henryalejandrorieraloza-sudo/WRO-2026-Future-Engineers-Journal/video/video.md

# Performance videos

Rule 7 of the WRO 2026 Future Engineers General Rules asks for **one YouTube video for each challenge** (public or accessible by link), where the part showing the vehicle **driving autonomously lasts at least 30 seconds**.

| Challenge | Video | Status |
|---|---|---|
| Open Challenge (3 laps, random inner walls, stop in the starting section) | — | In progress — to record with the final Open Challenge program |
| Obstacle Challenge (3 laps obeying red / green pillars, then parallel parking) | — | In progress — to record with the final Obstacle Challenge program |
| Earlier autonomous driving demonstration | https://www.youtube.com/watch?v=J5yrJuZZ5P8 | Done |

**Recording checklist:** one continuous take; show the car switched off in the starting zone, the power switch, the start button and then the whole run without touching the car; at least 30 s of autonomous driving; say the driving direction and the date in the video description.

Team channel: https://www.youtube.com/@SJVL67
