henryalejandrorieraloza-sudo/WRO-2026-Future-Engineers-Journal/t-photos/README.md

# Team photos

| Official photo | Fun photo |
|---|---|
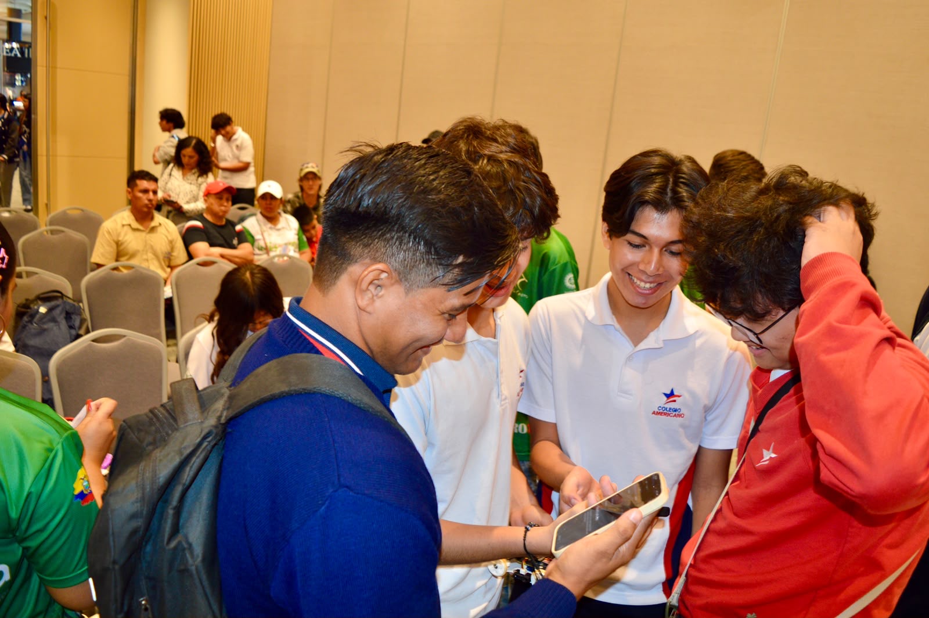
[picture p91: t-photos/team_funny.jpg]
|  |  |
| Team X67 with our coach at the WRO 2026 Ecuador national final | Reviewing a test run on a phone during the national final |

More pictures of the competition day are in [`../other/team-journey`](../other/team-journey).
