henryalejandrorieraloza-sudo/WRO-2026-Future-Engineers-Journal/other/team-journey/opening_ceremony.jpg

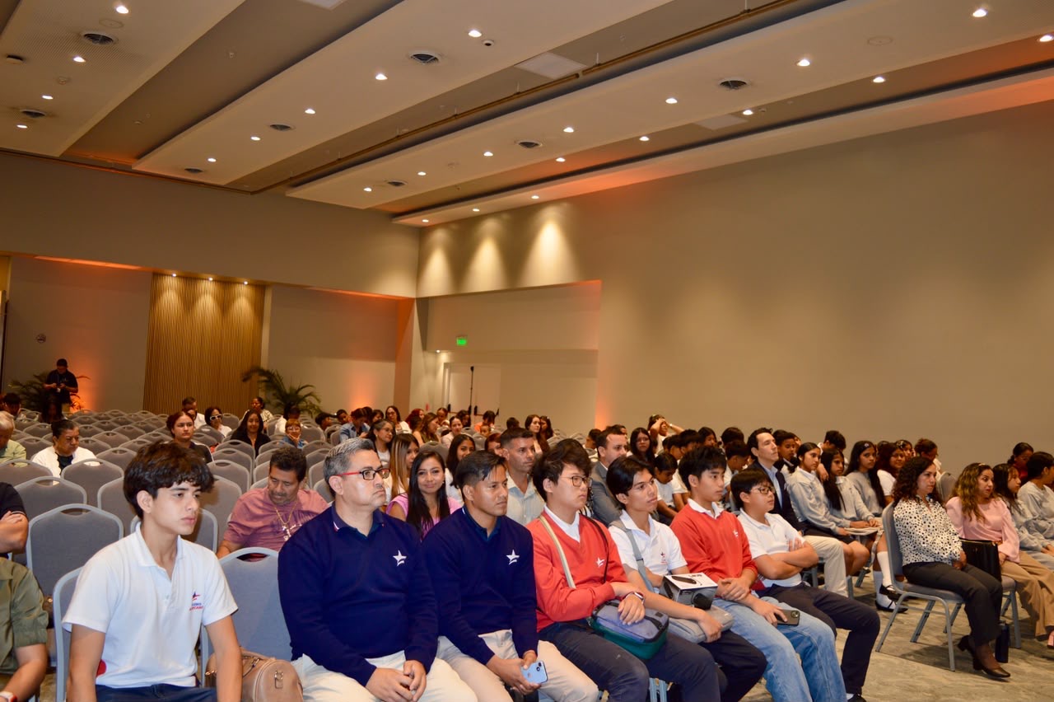
other/team-journey/opening_ceremony.jpg
