henryalejandrorieraloza-sudo/WRO-2026-Future-Engineers-Journal/other/team-journey/press_interview.jpg

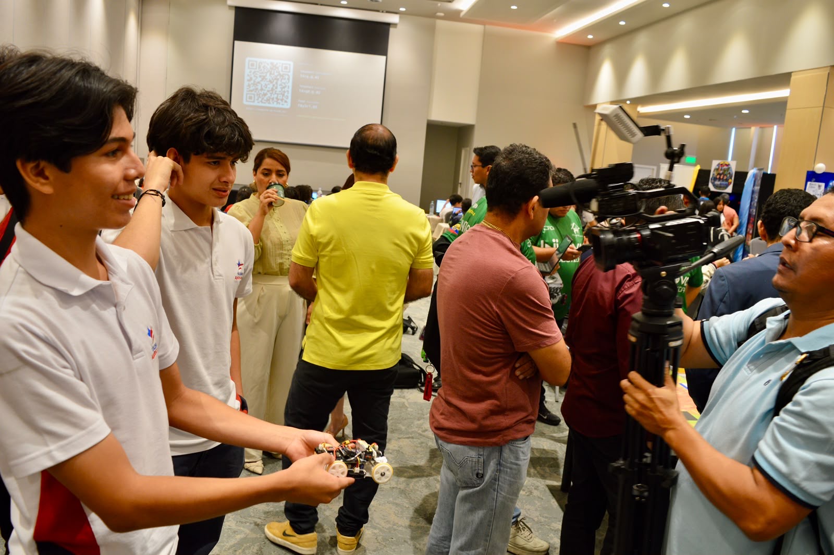
other/team-journey/press_interview.jpg
