henryalejandrorieraloza-sudo/WRO-2026-Future-Engineers-Journal/other/team-journey/robot_presentation_1.jpg

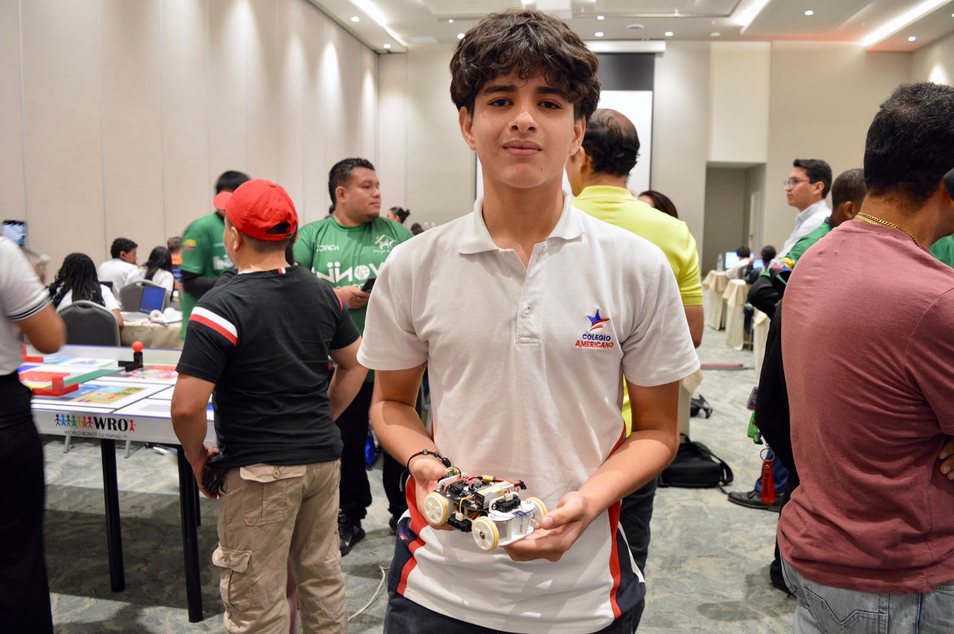
other/team-journey/robot_presentation_1.jpg
