henryalejandrorieraloza-sudo/WRO-2026-Future-Engineers-Journal/models/stl/steering_gear.stl

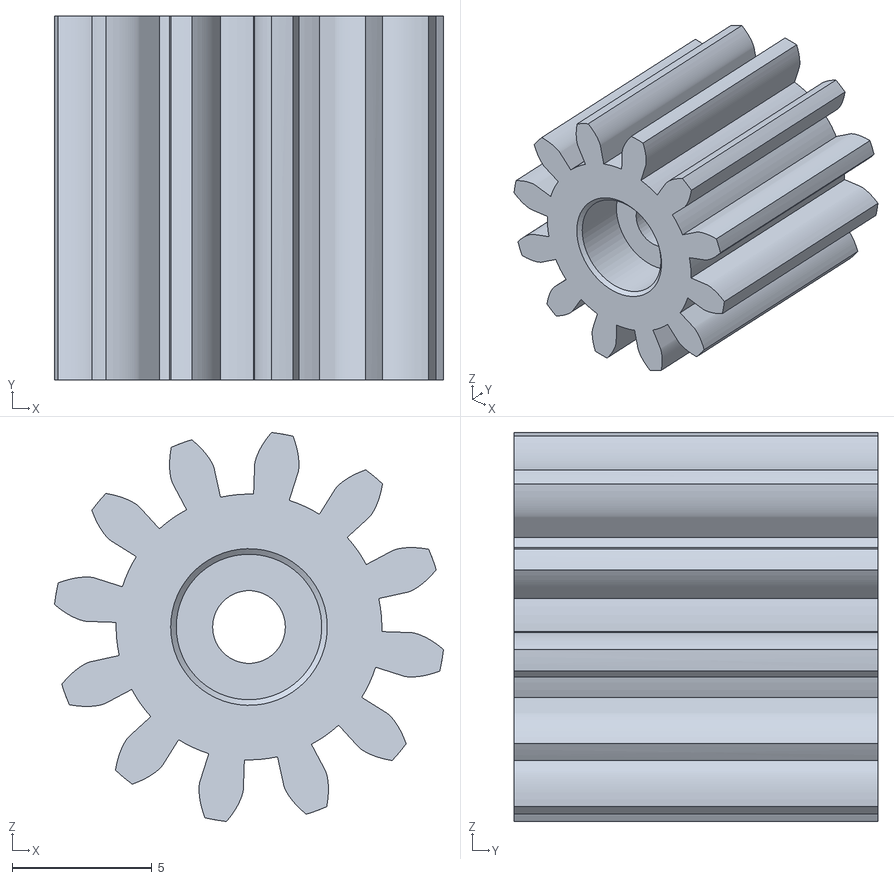
[picture p96: CAD file, 2026-10-19]
models/stl/steering_gear.stl
13.9 x 13.0 x 13.9
