henryalejandrorieraloza-sudo/WRO-2026-Future-Engineers-Journal/models/stl/pcb_big_support_left.stl

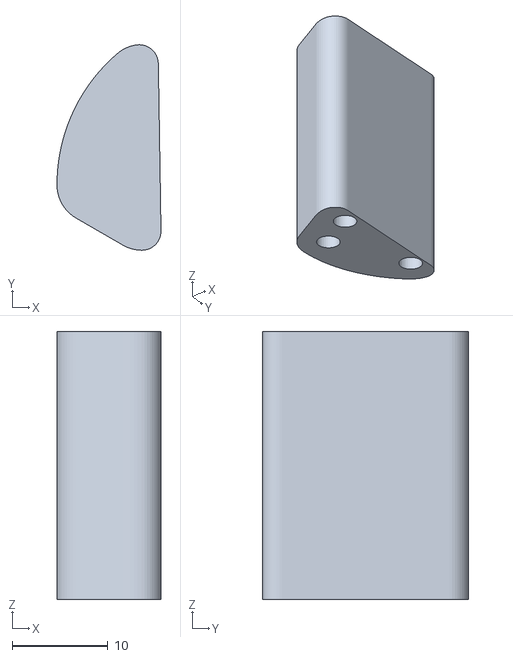
[picture p97: CAD file, 2026-10-19]
models/stl/pcb_big_support_left.stl
10.9 x 21.5 x 28.0
