henryalejandrorieraloza-sudo/WRO-2026-Future-Engineers-Journal/models/stl/rear_wheel.stl

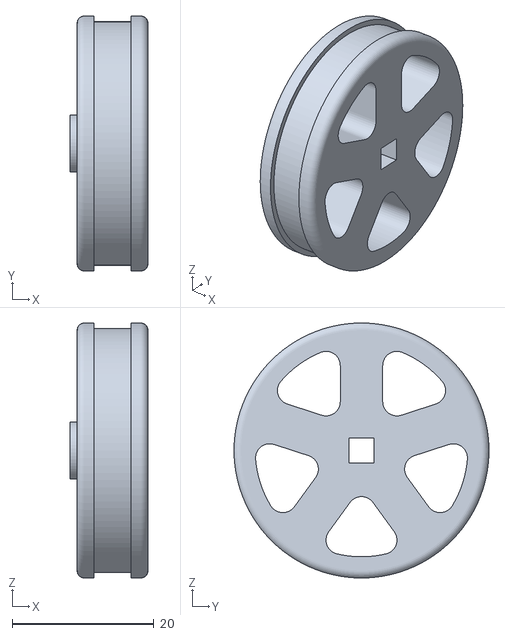
[picture p98: CAD file, 2026-10-19]
models/stl/rear_wheel.stl
11.0 x 36.0 x 36.0
