henryalejandrorieraloza-sudo/WRO-2026-Future-Engineers-Journal/models/stl/motor_restrain.stl

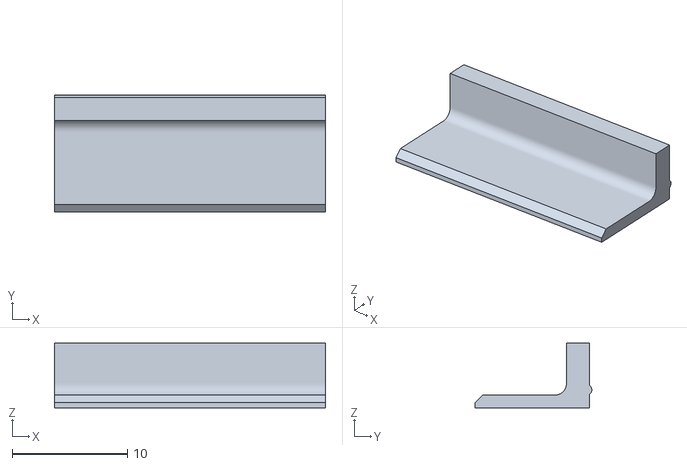
[picture p99: CAD file, 2026-10-19]
models/stl/motor_restrain.stl
23.5 x 10.1 x 5.60
