henryalejandrorieraloza-sudo/WRO-2026-Future-Engineers-Journal/models/stl/rear_sensor_bracket.stl

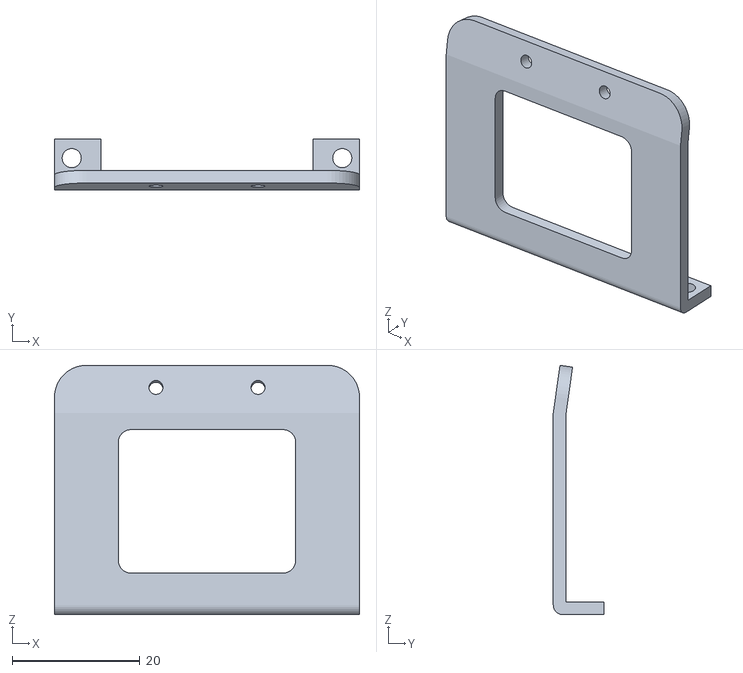
[picture p100: CAD file, 2026-10-19]
models/stl/rear_sensor_bracket.stl
47.8 x 7.92 x 39.1
