henryalejandrorieraloza-sudo/WRO-2026-Future-Engineers-Journal/models/stl/rear_spacer.stl

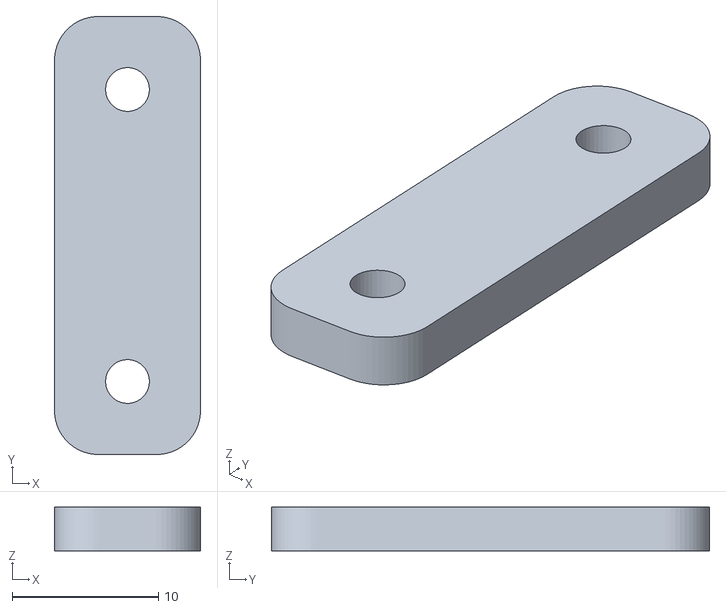
[picture p101: CAD file, 2026-10-19]
models/stl/rear_spacer.stl
10.0 x 30.0 x 3.00
