henryalejandrorieraloza-sudo/WRO-2026-Future-Engineers-Journal/models/stl/base.stl

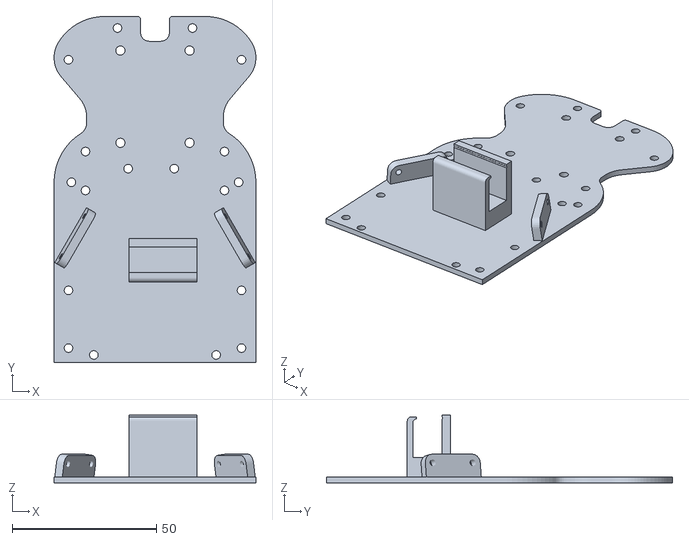
[picture p102: CAD file, 2026-10-19]
models/stl/base.stl
70.0 x 120.0 x 23.4
