henryalejandrorieraloza-sudo/WRO-2026-Future-Engineers-Journal/models/stl/servo_bracket.stl

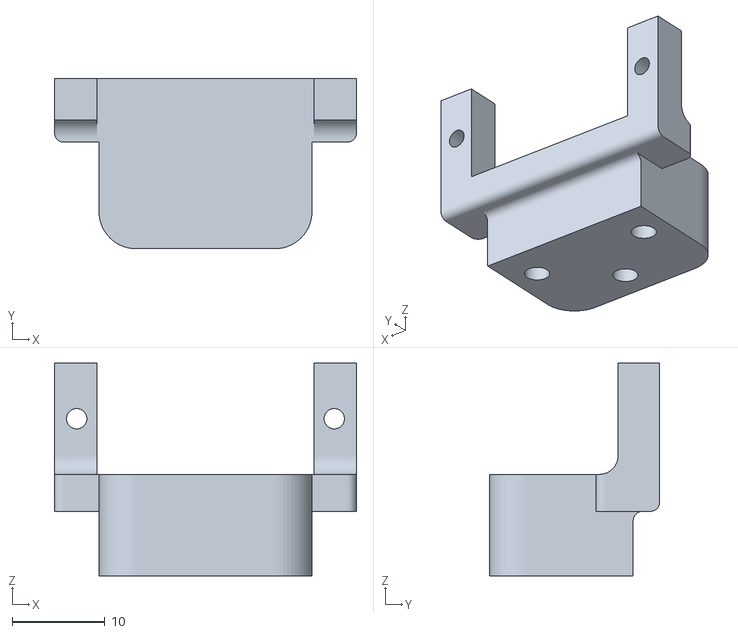
[picture p103: CAD file, 2026-10-19]
models/stl/servo_bracket.stl
32.6 x 18.4 x 23.0
