henryalejandrorieraloza-sudo/WRO-2026-Future-Engineers-Journal/models/stl/front_wheel.stl

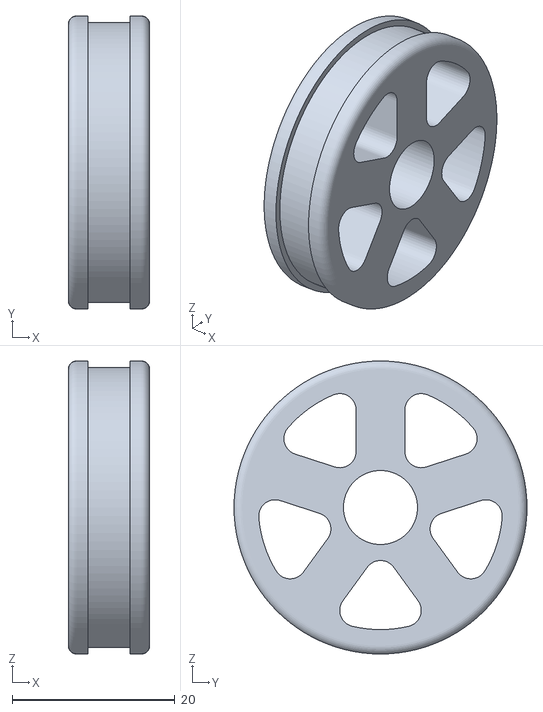
[picture p104: CAD file, 2026-10-19]
models/stl/front_wheel.stl
10.00 x 36.0 x 36.0
