henryalejandrorieraloza-sudo/WRO-2026-Future-Engineers-Journal/models/stl/sensor_bracket.stl

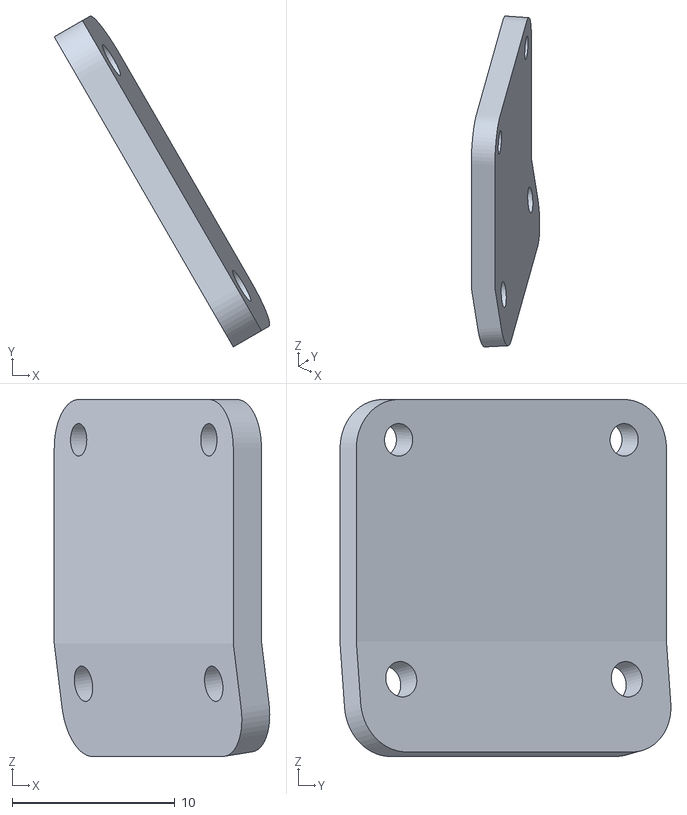
[picture p105: CAD file, 2026-10-19]
models/stl/sensor_bracket.stl
13.2 x 20.3 x 21.9
