henryalejandrorieraloza-sudo/WRO-2026-Future-Engineers-Journal/models/stl/diff_bevel_gear.stl

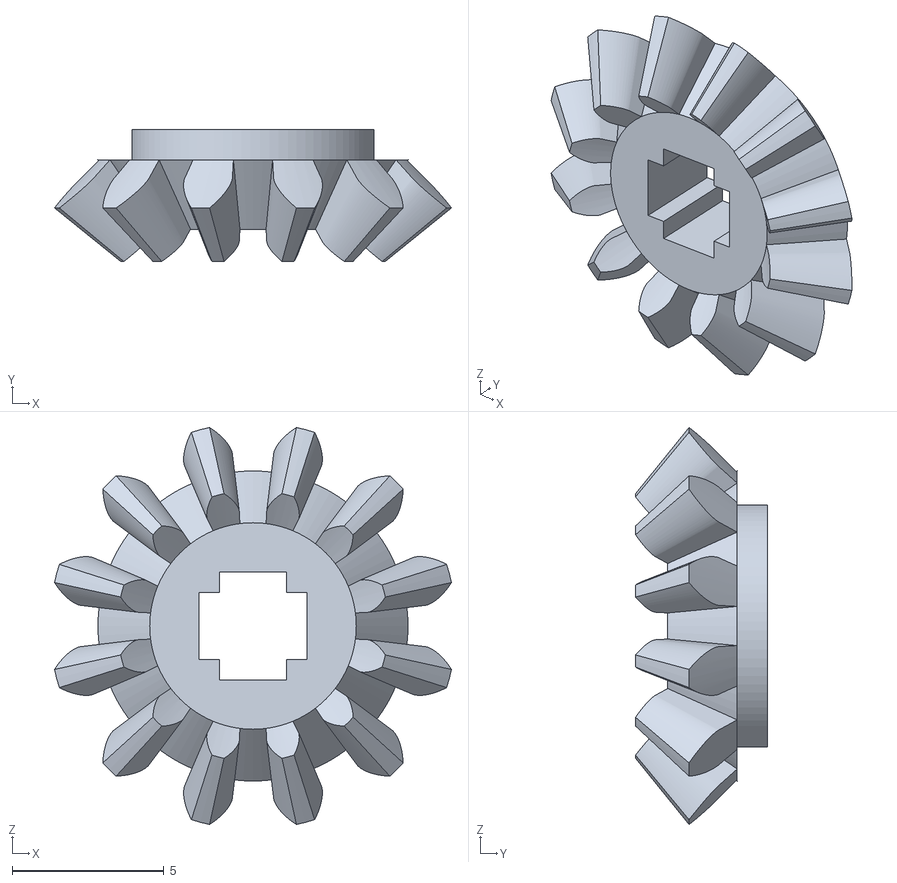
[picture p106: CAD file, 2026-10-19]
models/stl/diff_bevel_gear.stl
13.1 x 4.36 x 13.1
