henryalejandrorieraloza-sudo/WRO-2026-Future-Engineers-Journal/models/stl/gear_rack.stl

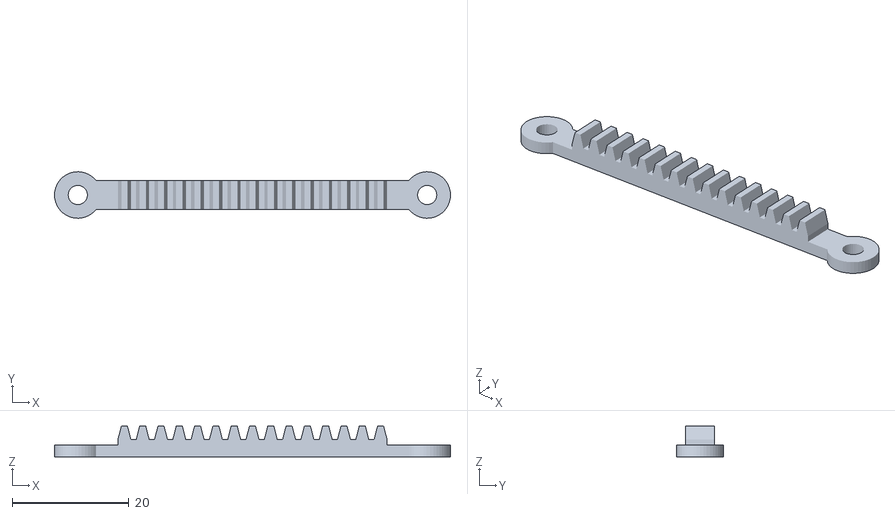
[picture p107: CAD file, 2026-10-19]
models/stl/gear_rack.stl
68.0 x 8.00 x 5.25
