henryalejandrorieraloza-sudo/WRO-2026-Future-Engineers-Journal/models/stl/diff_small_axle.stl

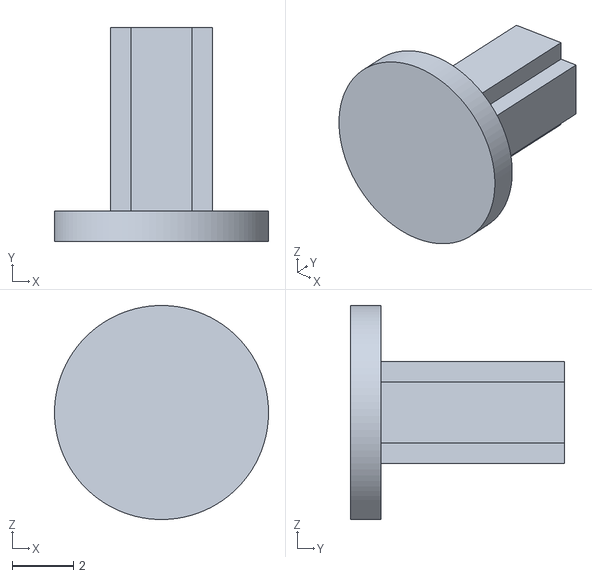
[picture p108: CAD file, 2026-10-19]
models/stl/diff_small_axle.stl
7.00 x 7.00 x 7.00
