henryalejandrorieraloza-sudo/WRO-2026-Future-Engineers-Journal/models/stl/front_spacer.stl

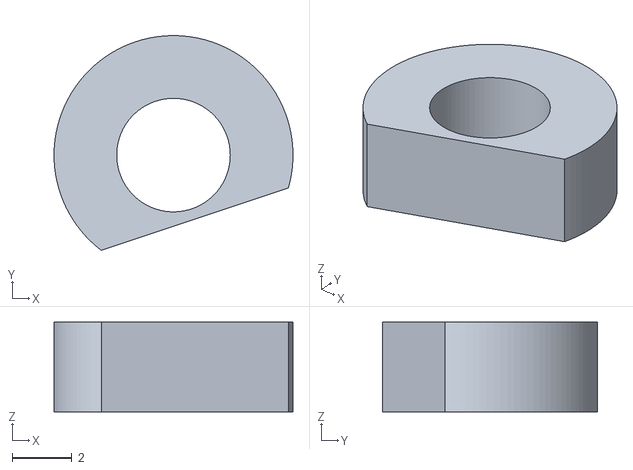
[picture p109: CAD file, 2026-10-19]
models/stl/front_spacer.stl
8.00 x 7.19 x 3.00
