henryalejandrorieraloza-sudo/WRO-2026-Future-Engineers-Journal/models/stl/differential_gear.stl

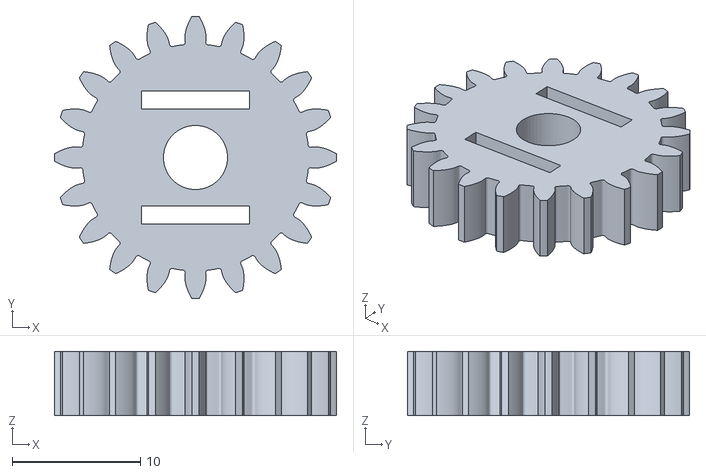
[picture p110: CAD file, 2026-10-19]
models/stl/differential_gear.stl
22.0 x 22.0 x 5.00
