henryalejandrorieraloza-sudo/WRO-2026-Future-Engineers-Journal/models/stl/camera_bracket.stl

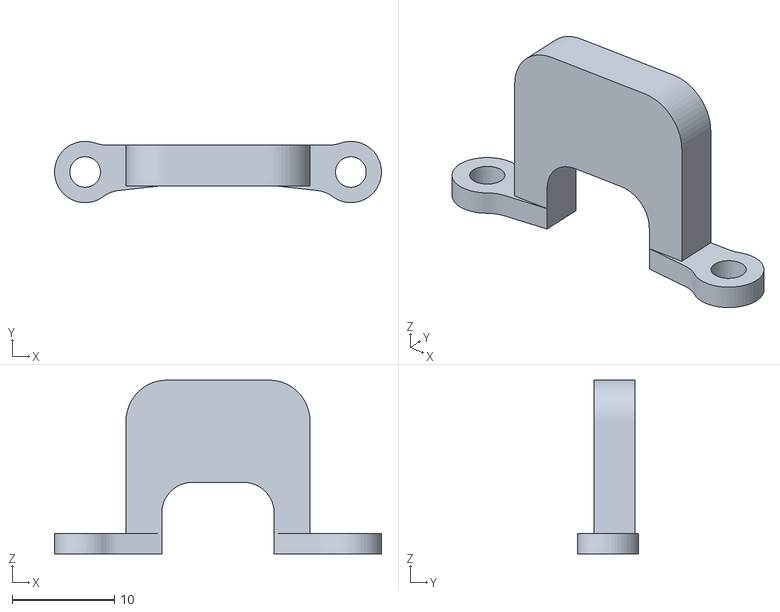
[picture p111: CAD file, 2026-10-19]
models/stl/camera_bracket.stl
32.0 x 6.00 x 17.0
