henryalejandrorieraloza-sudo/WRO-2026-Future-Engineers-Journal/models/stl/front_sensor_bracket.stl

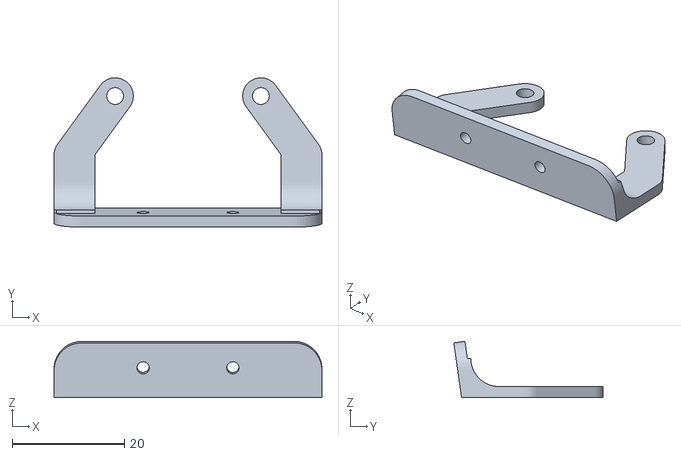
[picture p112: CAD file, 2026-10-19]
models/stl/front_sensor_bracket.stl
47.8 x 26.6 x 10.1
