henryalejandrorieraloza-sudo/WRO-2026-Future-Engineers-Journal/models/stl/diff_big_axle.stl

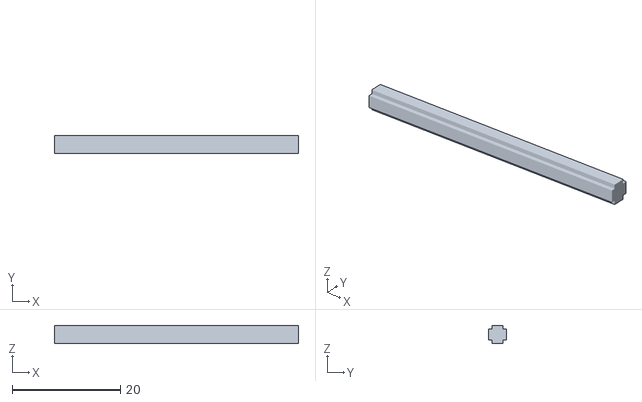
[picture p113: CAD file, 2026-10-19]
models/stl/diff_big_axle.stl
45.0 x 3.35 x 3.35
