henryalejandrorieraloza-sudo/WRO-2026-Future-Engineers-Journal/models/stl/pcb_front_support.stl

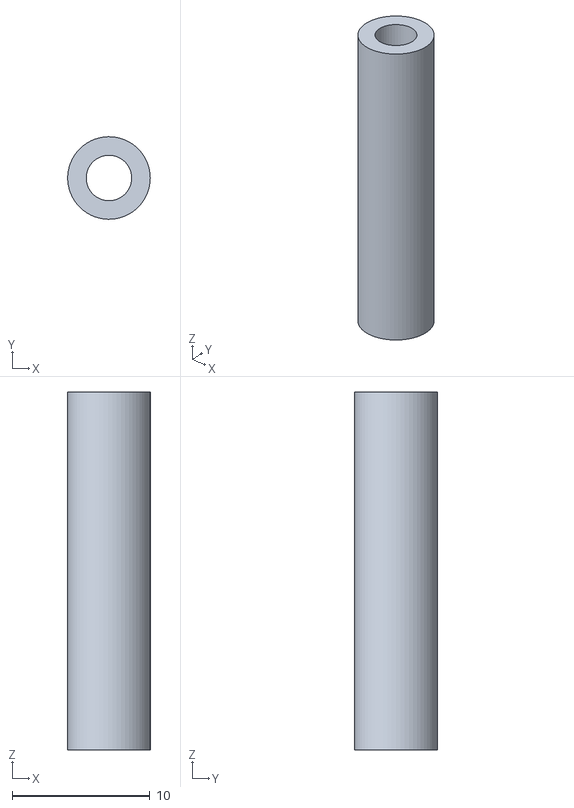
[picture p114: CAD file, 2026-10-19]
models/stl/pcb_front_support.stl
6.00 x 6.00 x 26.0
