henryalejandrorieraloza-sudo/WRO-2026-Future-Engineers-Journal/models/stl/right_steering_knuckle.stl

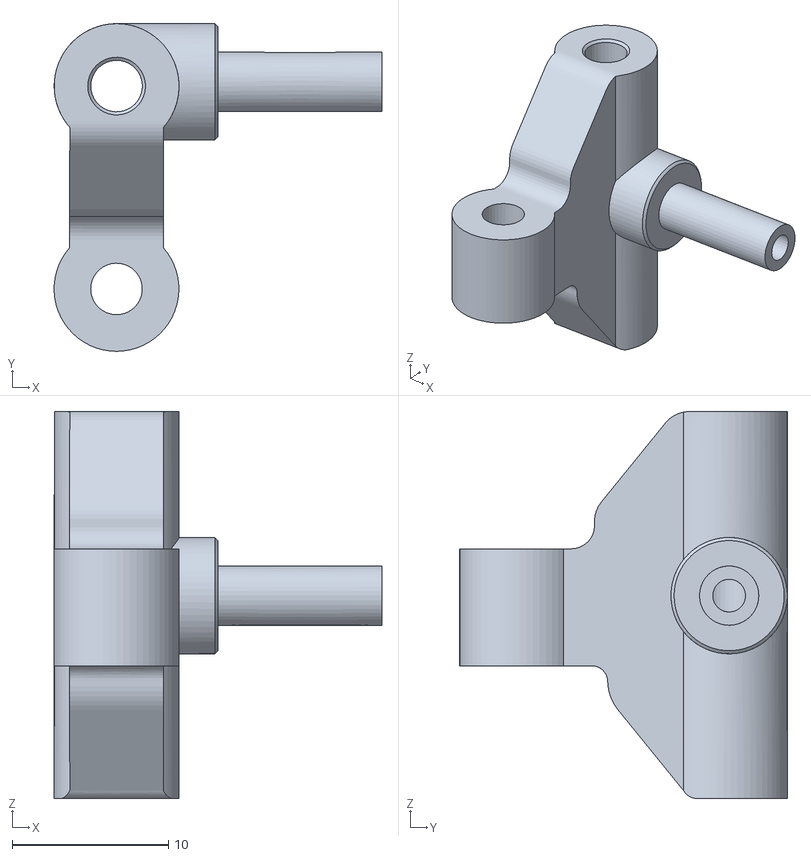
[picture p115: CAD file, 2026-10-19]
models/stl/right_steering_knuckle.stl
21.0 x 21.0 x 24.8
