henryalejandrorieraloza-sudo/WRO-2026-Future-Engineers-Journal/models/stl/motor_gear.stl

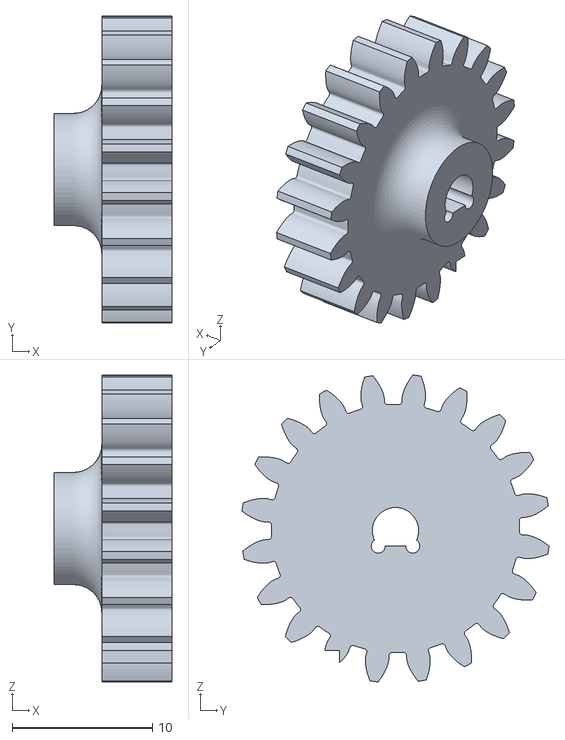
[picture p116: CAD file, 2026-10-19]
models/stl/motor_gear.stl
8.40 x 21.9 x 21.9
