henryalejandrorieraloza-sudo/WRO-2026-Future-Engineers-Journal/models/stl/differential_support.stl

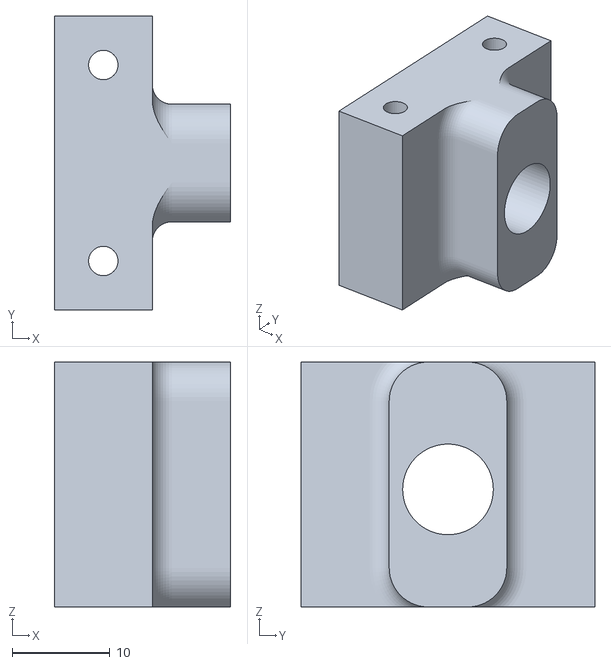
[picture p117: CAD file, 2026-10-19]
models/stl/differential_support.stl
18.0 x 30.0 x 25.0
