henryalejandrorieraloza-sudo/WRO-2026-Future-Engineers-Journal/models/stl/differential_box.stl

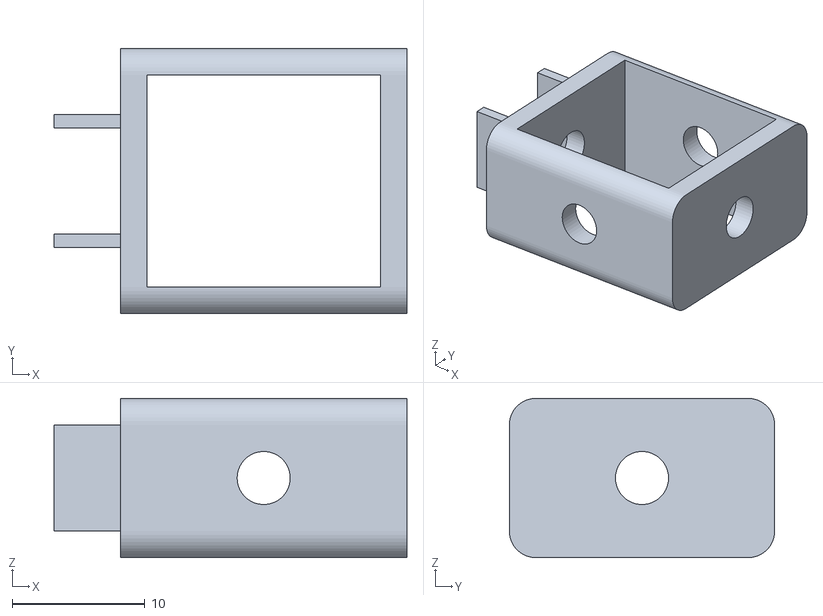
[picture p118: CAD file, 2026-10-19]
models/stl/differential_box.stl
26.6 x 20.0 x 12.0
