henryalejandrorieraloza-sudo/WRO-2026-Future-Engineers-Journal/(list of files, cad)

Other CAD files:
models/stl/pcb_big_support_right.stl
models/stl/left_steering_knuckle.stl
