henryalejandrorieraloza-sudo/WRO-2026-Future-Engineers-Journal/(commit log)

2026-10-06 Journal: Oct 5
    ROI test, TOF raised 2 cm, servo and Nano fails
2026-10-06 Restructure repository following the WRO Future Engineers template
    - src/: all Arduino code (hardware-tests, obstacle-challenge)
    - docs/: engineering journal and its images
    - models/, schemes/, t-photos/, v-photos/, video/: template folders
    - Remove the old duplicate copy of the journal
    - Rewrite src/README.md with a table of every sketch
    Claude-Session: https://claude.ai/code/session_011kiAbPqcUxpQtQPxuK5nY1
2026-10-06 Add servo calibration and first driving test; set TOF ROI to 1 x 6
    - servo_calibration: set the steering angle from the Serial Monitor
    to find the real centre and limits without forcing the linkage
    - drive_until_left_open: drive straight, brake when LEFT TOF > 170 cm
    - tof_sensors_test: ROI 1 x 6 from the 5 Oct experiment (journal 8.2)
    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
2026-10-06 Journal: Oct 5 chassis tests, TOF ROI experiment, problems 29-32
    - Section 8: first tests on the new chassis
    - ROI experiment (best: height 6, width 1) with Desmos plot
    - TOF sensors raised ~2 cm: Problem 16 solved
    - Servo travel, unsoldered TOF wire and Nano ESP32 overheating documented
    - Keep the edited Phase 2 title; links updated to the new folders
    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
2026-10-06 Add README: vehicle overview, wiring, software architecture and build steps
    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
2026-10-06 Add WRO 2026 Scenario Roulette tool and links to both web tools
    - src/tools/scenario-roulette/index.html: draws official track scenarios
    - README: new Web tools section (Pillar Vision Lab + Scenario Roulette)
    - Journal section 7: link to the roulette code
    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
2026-10-08 Complete documentation following the WRO 2026 rubric
    - Merge team's electrical docs: PCB schematic, wiring diagram, PCB
    manufacturing process, BOM, datasheets and component pictures
    - Add power budget, failure points, sensor placement and calibration
    - Fix pin map: STBY tied to +5 V, encoder on D2/D3, camera UART on D0/D1
    - Add team photos, vehicle photos, competition photos and video link
    - Rewrite README around the five rubric criteria with state-machine and
    subsystem diagrams, trade-off and risk tables, testing metrics
    - Add CHANGELOG with versions and release notes
    Claude-Session: https://claude.ai/code/session_01Su7rMMHa8BVfT2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
2026-10-08 Define final Open and Obstacle Challenge strategies
    - Open: keep start distances with PD (outer wall after first corner),
    corner by sudden side jump with ROI 1x6, 90 deg gyro turns, after the
    12th corner drive a short distance and brake
    - Obstacle: steer until the closest pillar is in the correct third of
    the image, corners by floor lines with gyro turn and counter; parking
    still being designed
    - Journal 8.5 and CHANGELOG v0.5 record the changes and reasons
    Claude-Session: https://claude.ai/code/session_01Su7rMMHa8BVfT2XsZwDh8A
2026-10-08 Align FRONT sensor role with the final strategy
    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
2026-10-15 Add pinion-and-rack steering tests and wall-following PID sketches
    Claude-Session: https://claude.ai/code/session_01NdfSgZBs4d4o7EYARFNAF8
2026-10-19 Add 3D models: 25 STL parts, renders, CAD v1-v3 and tyre casting process
    Claude-Session: https://claude.ai/code/session_01HY3bk2f32DfQiL1SZisxqG
2026-10-19 Add six official vehicle views, soldered PCB, build-process and retired-parts photos
    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
2026-10-19 Document chassis v3: rack-and-pinion steering, silicone tyres, 3.3 V TOF power budget, journal Phase 7
    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
2026-10-20 Add smooth gyro wall following (validated) and journal Phase 8
    Claude-Session: https://claude.ai/code/session_01FKkB6X5Z1E7WXCxDveg897
2026-10-20 Add corner detection with the front TOF (side sensors detect, front decides when to brake)
    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
2026-10-20 Replace the TOF and gyro tests with tof_gyro_sensors_test (4 TOF + BMI160, Nano classic)
    Claude-Session: https://claude.ai/code/session_01HaHWXS6WvAV9Ghad7tTnoK
2026-10-21 Add turn_left_90_pid_brake: validated 90-degree left turn with gyro PD and active brake
    Claude-Session: https://claude.ai/code/session_01SgySuPU4uoKPfYuGYeEpuJ
2026-10-22 Add exito_glorioso: validated straight + corner with gyro wall following and 90-degree turn
    Claude-Session: https://claude.ai/code/session_01NXwmd5huxXsZMppxAGB2v6
2026-10-22 Add exito_rotundo: timed corner with opening memory, smooth wall switch and heading integral
    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
2026-10-25 v1.2: side TOF could not see the black wall -> straight sensors, ROI 16x8, simpler and safer algorithm
    - Journal Phase 9 (21-24 Oct): one complete corner validated, 13-turn loop,
    drift toward the inner wall fixed by using the wall as heading reference.
    - Journal Phase 10 (24-25 Oct): three measured experiments show the side TOF
    at 30 deg with ROI 1x6 read ~2 m at every distance on the black wall;
    straight sensor + ROI 16x8 measures it within 1-2 cm up to ~45 cm.
    - New decision logic (WALL / NO WALL / NOT SURE, window of 8 readings) and
    explicit safety rules; Problems 40-46; journal 8.2 marked as overturned.
    - README 6.3, 8 (new state machine), 10 and 13 updated.
    - Added tof_left_righ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
2026-10-25 v1.3: rules compliance review against the WRO 2026 General Rules
    - README: corrected challenge facts, new rules compliance table (3.1) and
    submission checklist with the rule 7 deadlines (14.1).
    - Open Challenge: 12 turns for the competition (rule 9.24.3), edge cases for
    the 600 mm corridor and the outer wall.
    - video.md: one video per challenge required; camera web server marked as
    bench test only (no Wi-Fi in rounds, rule 11.10).
    - Journal next steps: final programs, videos, scoring deadline, hard copy.
    Claude-Session: https://claude.ai/code/session_01FMVcL6JTPHCZ4vQALdizHT
2026-10-25 v1.4: justify every Open Challenge setting with data, geometry or rules
    - README 10.4: table of every setting with value, reason and evidence.
    - Journal 12.8: settings without justification or disproved by the data,
    and what replaced them (12 turns, ~250 mm target, 8-reading window, ...).
    - Fixed outdated sensor roles, gyro calibration, speed reasoning, encoder
    status and TOF mode in README and schemes/README.
    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
2026-10-26 v1.5: Open Challenge decision tree with encoder delays
    Claude-Session: https://claude.ai/code/session_01PRwaxgTpDA4woYDDBHiES6
2026-10-28 v1.6: Obstacle Challenge in centimetres - straight with pillars, camera v3, floor lines
    - src/obstacle-challenge: obstacle_camera (v3), straight_pillars (validated 27 Oct), line_test
    - README §9 rewritten: pinhole model, odometry map, steering law, row -> cm, corner plan, roadmap
    - Journal Phase 11 (section 13) with measurements and Problems 47-58
    - src/README, CHANGELOG, status, decisions and risks updated
    Claude-Session: https://claude.ai/code/session_01P9CceafiQHrBMtGZRo2Xhy
2026-10-28 Journal §13.3: the math of the Obstacle Challenge, step by step
    tan/atan, pinhole camera, distance from the width (two faces), rotation between car and map,
    odometry, atan2 steering, gyro PD, row -> cm from the floor plane, least squares centre row,
    corner geometry - each with its reason and a worked example. Linked from README §9.1.
    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
2026-10-28 Camera v3.1: floor lines without false detections (28 Oct)
    - Floor-above check: a line needs white floor above most of its
    columns, so the bottom edge of the black wall is rejected
    - Blue starts at hue 110 (floor near the car reaches 85)
    - Colour probe in the status print (H, S, V of two fixed boxes)
    - Validated: no false lines on the empty floor or the wall; orange
    from 16 cm, blue from 9 cm, 12.5 fps
    - README 9.2 / 9.6 / 9.10 / 13, CHANGELOG v1.7, journal 13.6 with
    Problems 57-62 (including the changes that were reverted)
    Claude-Session: https://claude.ai/code/session_01P9CceZRZpis8sWCEgUBDCs
2026-11-05 Move hardware-test sketches and docs to the classic Arduino Nano
    Claude-Session: https://claude.ai/code/session_01P9CceZS9oJ8vDcpsCcmDZ5
2026-11-05 servo_calibration: make it compile on the classic Arduino Nano
    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
2026-11-11 Add tof + servo sensors test for Arduino Nano
    Sketch that only drives the steering servo (D9) and reads the two lateral
    VL53L1X sensors, each given its own I2C address via XSHUT (A3 left, A2 right).
    No motor or gyro code.
    Claude-Session: https://claude.ai/code/session_01P9CceZG1buKGCn9mgz5J9s
2026-11-11 Remove old sensor, gyro and servo test sketches
    Replaced by src/hardware-tests/tof_servo_sensors_test. Still in git history if needed.
    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
